SuperHouse/UT61EWIFI/Images/UT61EWIFI-v1_0-back-oblique.jpg

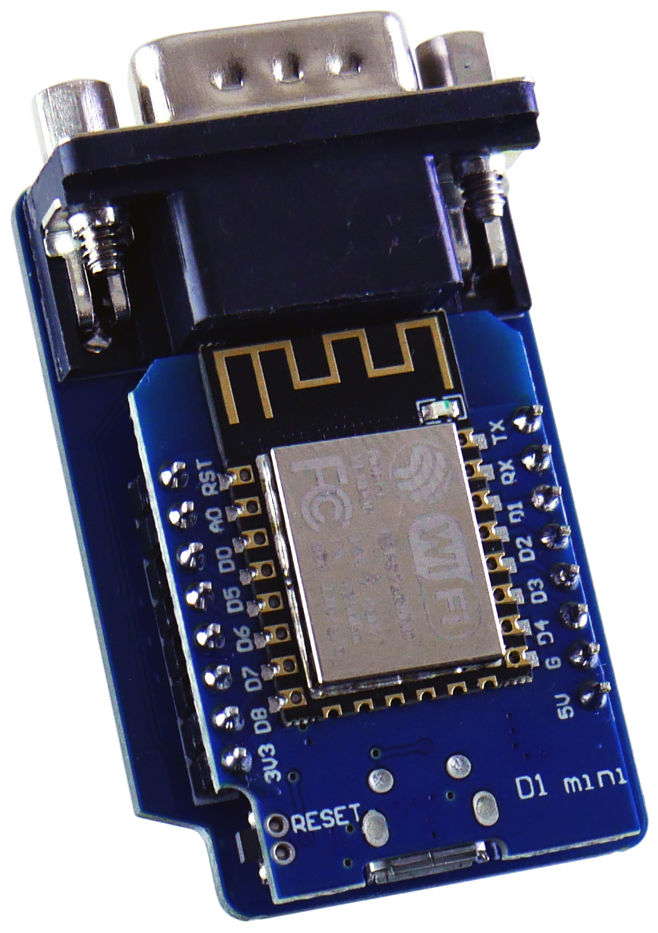
Images/UT61EWIFI-v1_0-back-oblique.jpg
