SuperHouse/UT61EWIFI/Images/UT61EWIFI-v1_0-back.jpg

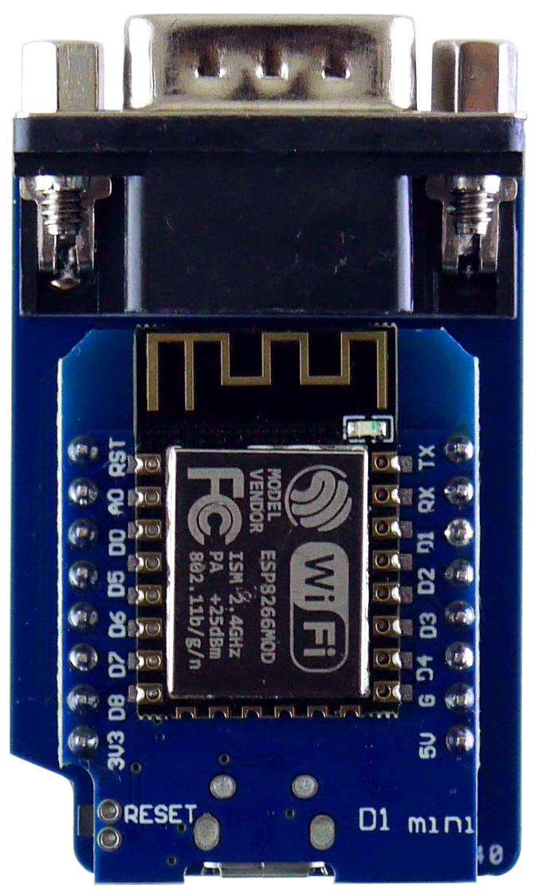
Images/UT61EWIFI-v1_0-back.jpg
