SuperHouse/UT61EWIFI/Images/UT61EWIFI-v1_0-front.jpg

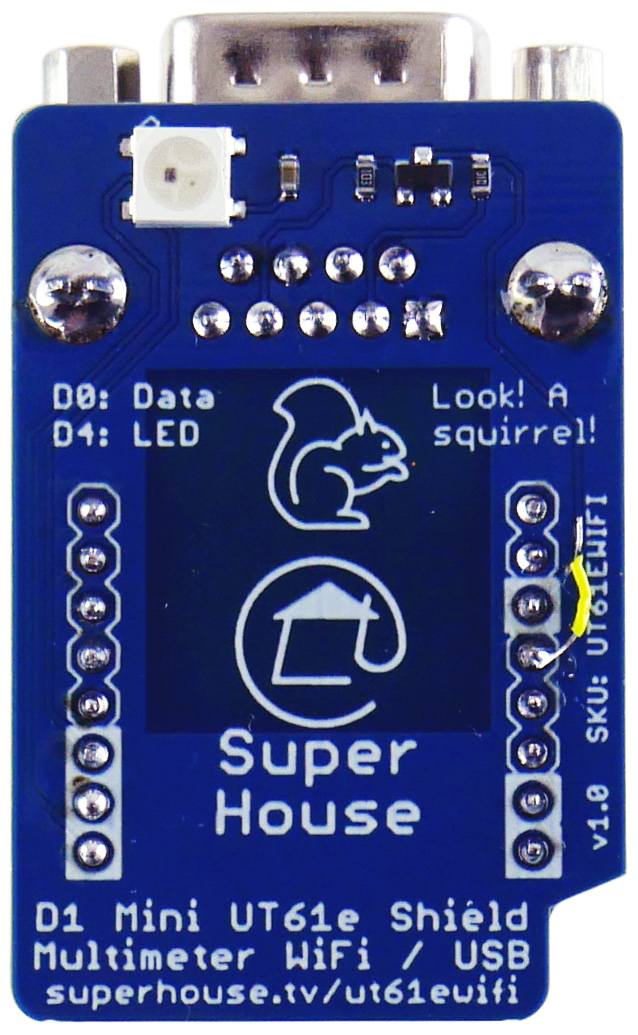
Images/UT61EWIFI-v1_0-front.jpg
