SuperHouse/UT61EWIFI/Images/UT61EWIFI-v1_0-render2.jpg

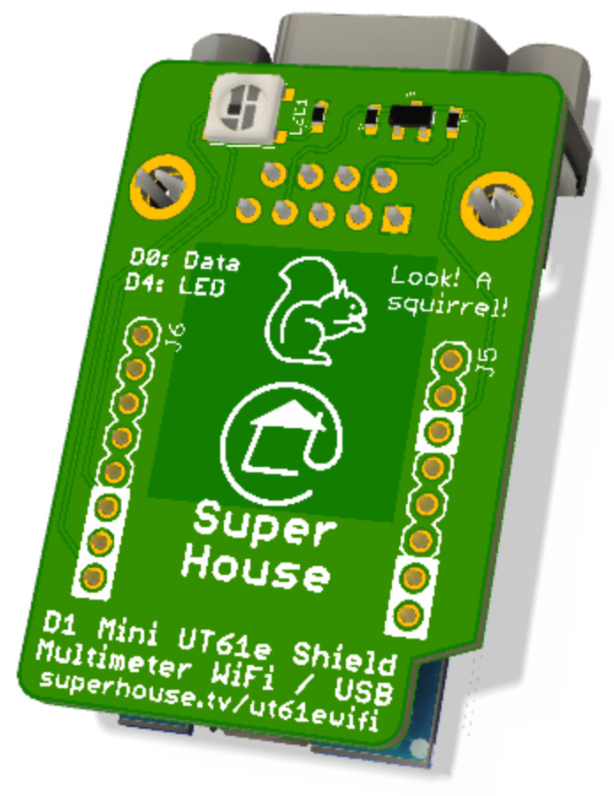
Images/UT61EWIFI-v1_0-render2.jpg
