SuperHouse/UT61EWIFI/Images/UT61EWIFI-v1_1-top.jpg

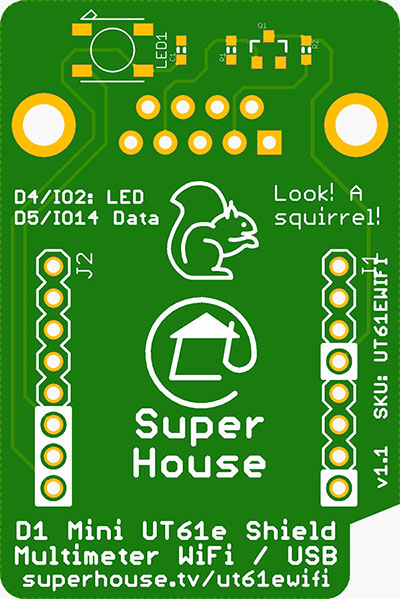
Images/UT61EWIFI-v1_1-top.jpg
