SuperHouse/UT61EWIFI/Resources/Screen Shot 2021-05-06 at 2.59.59 pm.png

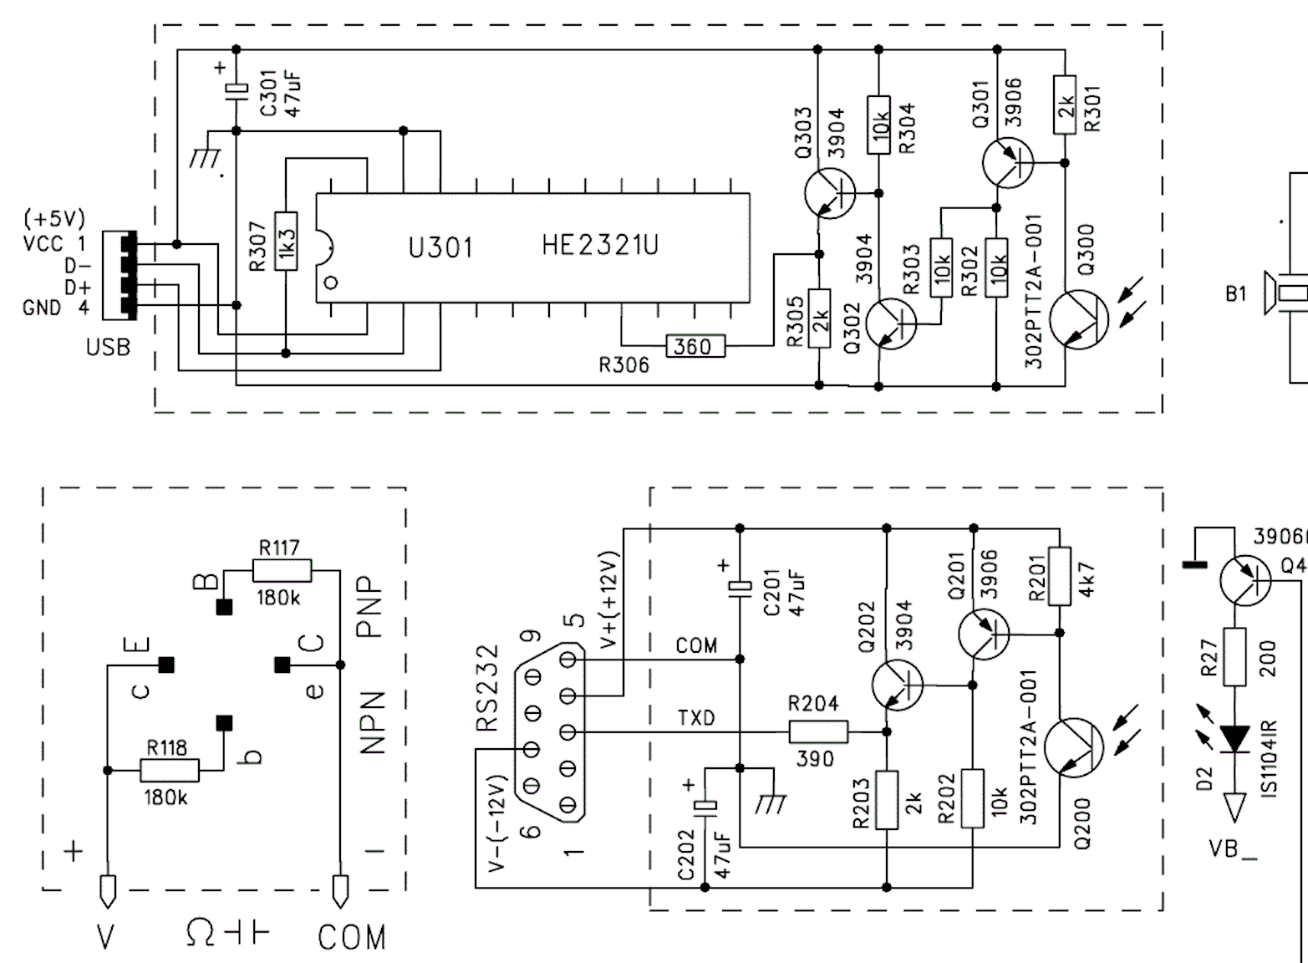
Resources/Screen Shot 2021-05-06 at 2.59.59 pm.png
