SuperHouse/UT61EWIFI/Resources/uni-t-ut61e-multimeter-circuit-diagram.gif

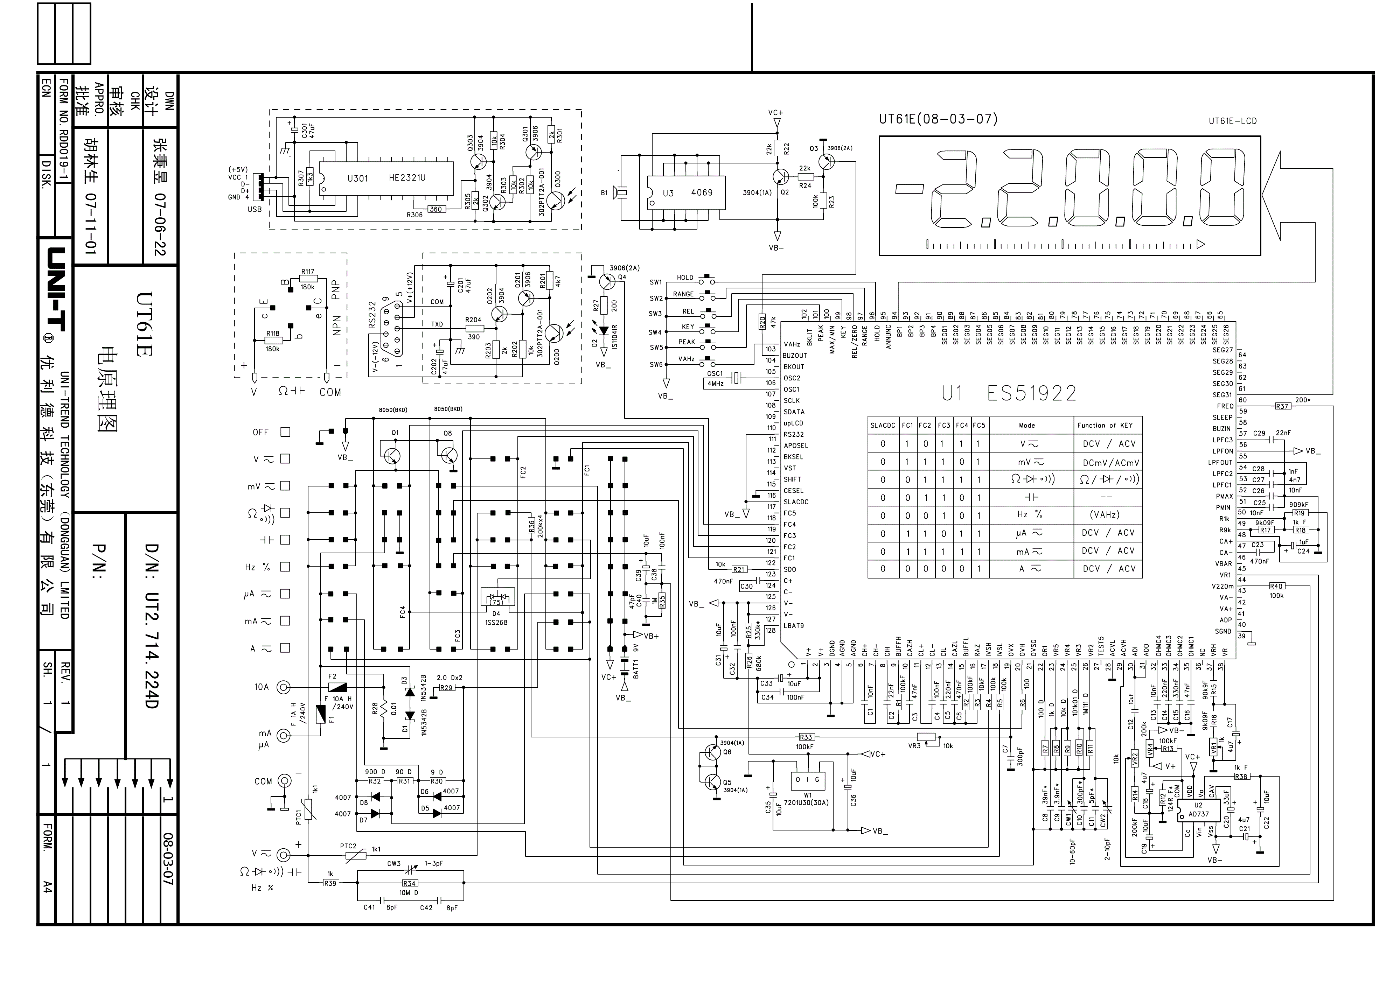
Resources/uni-t-ut61e-multimeter-circuit-diagram.gif
