SuperHouse/UT61EWIFI/Hardware/UT61EWIFI.brd

## EAGLE design Hardware/UT61EWIFI.brd (2021-07-12)

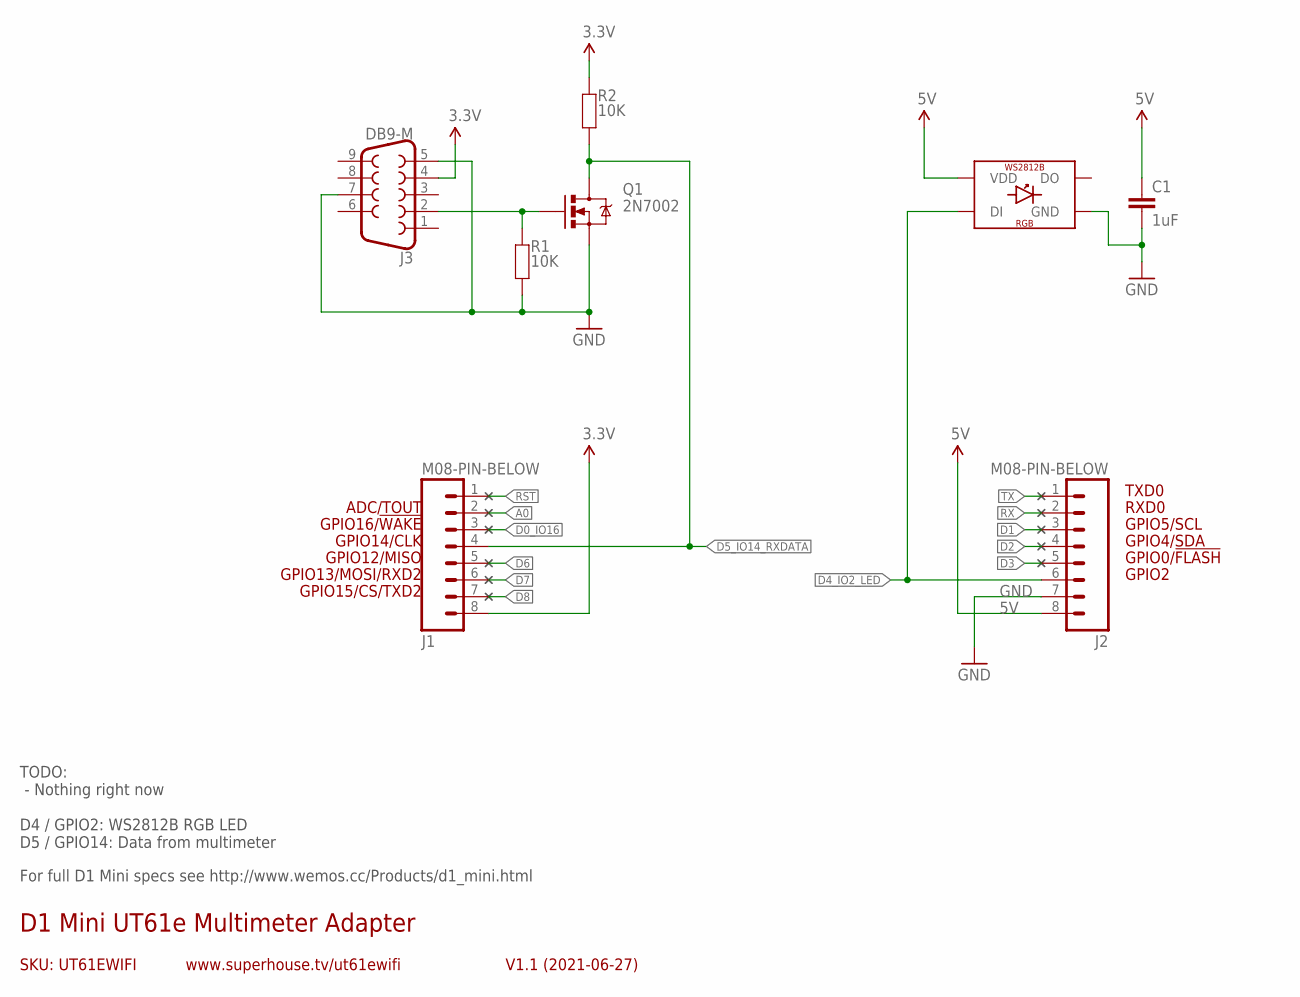
[picture p12: schematic UT61EWIFI.sch]

Parts:
C1: 1uF; C0603
J1, J2: M08-PIN-BELOW; 1X08-P-BELOW
J3: DB9-M; DB9-PCB-PLUG
LED1: WS2812B
Q1: 2N7002; SOT23-3
R1, R2: 10K; R0603

Connections:
3.3V: J1.8, J3.4, R2.2
5V: C1.1, J2.8, LED1.1-VDD (VDD)
A0: J1.2
D0_IO16: J1.3
D1: J2.3
D2: J2.4
D3: J2.5
D4_IO2_LED: J2.6, LED1.4-DIN (DI)
D5_IO14_RXDATA: J1.4, Q1.3 (D), R2.1
D6: J1.5
D7: J1.6
D8: J1.7
GND: C1.2, J2.7, J3.5, J3.7, LED1.3-GND (GND), Q1.2 (S), R1.1
unnamed: J3.2, Q1.1 (G), R1.2
RST: J1.1
RX: J2.2
TX: J2.1

Notes on the sheet:
GPIO2
GPIO0/!FLASH
GPIO12/MISO
GPIO4/SDA
GPIO5/SCL
RXD0
TXD0
GPIO13/MOSI/RXD2
GPIO14/CLK
GPIO15/CS/TXD2
GPIO16/!WAKE
SKU: UT61EWIFI
D1 Mini UT61e Multimeter Adapter
V1.1 (2021-06-27)
www.superhouse.tv/ut61ewifi
ADC/TOUT
TODO: - Nothing right now D4 / GPIO2: WS2812B RGB LED D5 / GPIO14: Data from multimeter
For full D1 Mini specs see http://www.wemos.cc/Products/d1_mini.html

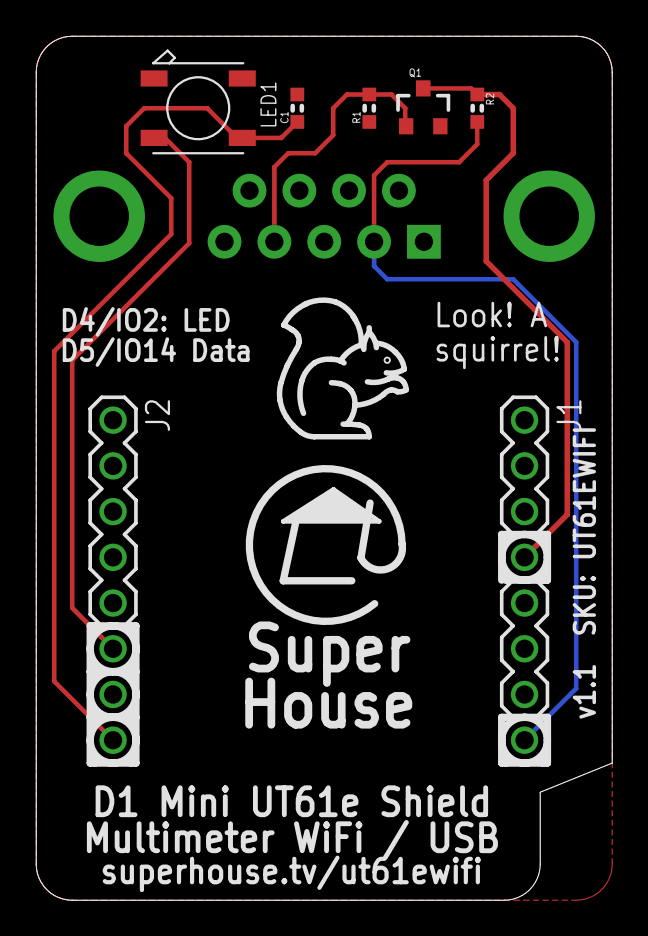
[picture p13: board UT61EWIFI.brd from above]

Board: 2 copper layers, 32.0 x 48.0 mm, 8 parts (1 on the bottom side), 6 nets.
