SuperHouse/UT61EWIFI/(commit log)

2021-04-03 Added files copied from AXAWIFI project.
    [UT61EWIFI.brd, UT61EWIFI.sch]
2021-04-03 Added voltage regulator. Added IR input.
    [UT61EWIFI.brd, UT61EWIFI.sch]
2021-05-02 Added resources directory and schematic.
2021-06-27 Changed multimeter data pin from D0 to D5 for v1.1 release.
    [UT61EWIFI.brd, UT61EWIFI.sch]
2021-06-27 Renamed ESP32 version of firmware for clarity.
2021-06-27 Added info about mistake in UT61E schematic and comparitors.
2021-06-28 Added image into README.
    [UT61EWIFI.brd]
2021-06-29 Added photos of real board.
2021-06-29 Replaced render with photo of the real board.
2021-06-30 Added support for WS2812B status LED.
2021-07-05 Improved boot status display on RGB LED. Removed legacy ESP32 code. Changed device ID to upper case in MQTT topics and MQTT client id. Display link to project page in terminal at startup.
2021-07-12 Restructured schematic to make it neater.
    [UT61EWIFI.brd, UT61EWIFI.sch]
2021-07-24 Start work towards changing from PubSubClient to ArduinoMqttClient
2021-08-09 Updated Node Red client to support new JSON schema for initial firmware created by CableTie
2021-08-12 Updated UI to support latest developments on the UT61EWiFiD1Mini firmware. Added support for Range, Hold and the following modes continuity, diode. Also added in new Icon for Low Battery status indic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
2021-08-12 Full update of ut61e_display REAME.md Fix detection of PMAX and PMIN
    [ut61e_display.cpp]
2021-08-12 Added display_digits generation Fixed display_string generation Added proper treatment of hold flag
    [UT61EWiFiD1Mini.ino, ut61e_display.cpp, ut61e_display.h]
2026-03-13 Added info about required board profile and libraries.
