SuperHouse/UT61EWIFI/(notices)

Notices in the files:
Hardware/UT61EWIFI.brd:
(C)2021 SuperHouse
Open Hardware License
parts and their libraries:
freetronics-original: Licensing: CC v3.0 Share-Alike You are welcome to use this library for commercial purposes.
